Sid110307/LoganLink/hardware/bom.csv

Sl No. | Designator | Description | Qty | MPN | DNP | Footprint | Value
1 | C1,C7 | MLCC 2.2uF 100V X7R 1206 | 2 | CL31B225KCHSNNE |  | Capacitor_SMD:C_1206_3216Metric | 2.2u 100V
2 | C2 | MLCC 100nF 100V X7R 0603 | 1 | GRM188R72A104KA35D |  | Capacitor_SMD:C_0603_1608Metric | 0.1u 100V
3 | C3 | MLCC 1nF 50V C0G 0402 | 1 | GRM1555C1H102JA01D |  | Capacitor_SMD:C_0402_1005Metric | 1n
4 | C4,C9,C13,C15 | MLCC 100nF 50V X7R 0402 | 4 | GCM155R71H104KE02D |  | Capacitor_SMD:C_0402_1005Metric | 0.1u
5 | C5 | MLCC 10nF 50V X7R 0402 | 1 | CL05B103KB5VPNC |  | Capacitor_SMD:C_0402_1005Metric | 10n
6 | C6,C12 | MLCC 1uF 25V X5R 0402 | 2 | GRT155R61E105KE01D |  | Capacitor_SMD:C_0402_1005Metric | 1u
7 | C8 | Aluminium electrolytic 22uF 63V SMD 6.3x7.7 (6.3 mm land pattern) | 1 | UCD1J220MCL1GS |  | Capacitor_SMD:CP_Elec_6.3x5.8 | 22u 63V
8 | C10,C11 | MLCC 22uF 16V X5R 1206 | 2 | GRM31CR61C226KE15L |  | Capacitor_SMD:C_1206_3216Metric | 22u
9 | C14,C16 | MLCC 10uF 10V X5R 0603 | 2 | GRM188R61A106ME69D |  | Capacitor_SMD:C_0603_1608Metric | 10u
10 | D1 | ESD protection diode LIN bus SOD-323 | 1 | PESD1LIN-SL |  | Diode_SMD:D_SOD-323 | PESD1LIN
11 | D2 | TVS diode bidirectional 33V standoff 1500W SMC | 1 | SMCJ33CA-13-F |  | Diode_SMD:D_SMC | SMCJ33CA
12 | D3 | Schottky diode 100V 2A SMA | 1 | SS210-HF |  | Diode_SMD:D_SMA | SS210
13 | D4 | Schottky diode 40V 1A SOD-323 | 1 | B5819WS |  | Diode_SMD:D_SOD-323F | B5819WS
14 | D5,D6 | Dual Schottky diode series 30V SOT-23 | 2 | BAT54S |  | Package_TO_SOT_SMD:SOT-23 | BAT54S
15 | D7 | Switching diode 100V SOT-23 | 1 | BAS16 |  | Package_TO_SOT_SMD:SOT-23 | BAS16
16 | F1 | Fuse fast 2A 63V 1206 | 1 | SF-1206FP200-2 |  | Fuse:Fuse_1206_3216Metric | 2A
17 | F2 | PTC resettable fuse 0.75A hold 6V 1206 | 1 | MF-NSMF075-2 |  | Fuse:Fuse_1206_3216Metric | 0.75A
18 | FB1 | Ferrite bead 600R at 100MHz 1206 | 1 | BLM31PG601SN1L |  | Inductor_SMD:L_1206_3216Metric | BLM31PG601SN1L
19 | J1 | OBD wire pads (not assembled) | 1 | - | DNP | Connector_PinHeader_2.54mm:PinHeader_1x06_P2.54mm_Vertical | OBD
20 | J2 | USB Type-C receptacle USB2.0 16P | 1 | USB4105-GF-A |  | Connector_USB:USB_C_Receptacle_GCT_USB4105-xx-A_16P_TopMnt_Horizontal | USB_C_Receptacle_USB2.0_16P
21 | J3 | UART console pads (not assembled) | 1 | - | DNP | Connector_PinHeader_2.54mm:PinHeader_1x04_P2.54mm_Vertical | UART
22 | L1 | Power inductor 22uH shielded 4x4 Isat 0.95A | 1 | SRN4018-220M |  | Inductor_SMD:L_Bourns-SRN4018 | 22u
23 | LED1 | LED red 0603 | 1 | APT1608EC |  | LED_SMD:LED_0603_1608Metric | Red
24 | LED2 | LED green 0603 | 1 | APT1608SGC |  | LED_SMD:LED_0603_1608Metric | Green
25 | Q1 | N-MOSFET 60V 0.3A SOT-23 | 1 | 2N7002K-7 |  | Package_TO_SOT_SMD:SOT-23 | 2N7002K
26 | R1 | Chip resistor 47R 1% 1/10W 0603 | 1 | RC0603FR-0747RL |  | Resistor_SMD:R_0603_1608Metric | 47
27 | R2,R6,R11,R20 | Chip resistor 100k 1% 1/16W 0402 | 4 | RC0402FR-07100KL |  | Resistor_SMD:R_0402_1005Metric | 100k
28 | R3,R25,R26 | Chip resistor 330R 1% 1/16W 0402 | 3 | RC0402FR-07330RL |  | Resistor_SMD:R_0402_1005Metric | 330
29 | R4,R5 | Chip resistor 5.1k 1% 1/16W 0402 | 2 | RC0402FR-075K1L |  | Resistor_SMD:R_0402_1005Metric | 5.1k
30 | R7,R15,R18 | Chip resistor 1M 0.5% 1/10W 0603 | 3 | RE0603DRE071ML |  | Resistor_SMD:R_0603_1608Metric | 1M
31 | R8,R16 | Chip resistor 150k 0.5% 1/10W 0603 | 2 | RT0603DRE07150KL |  | Resistor_SMD:R_0603_1608Metric | 150k
32 | R9 | Chip resistor 68k 0.5% 1/10W 0603 | 1 | RT0603DRE0768KL |  | Resistor_SMD:R_0603_1608Metric | 68k
33 | R10,R14,R21,R22 | Chip resistor 4.7k 1% 1/16W 0402 | 4 | RC0402FR-074K7L |  | Resistor_SMD:R_0402_1005Metric | 4.7k
34 | R12 | Chip resistor 4.7M 1% 1/16W 0402 | 1 | RC0402FR-074M7L |  | Resistor_SMD:R_0402_1005Metric | 4.7M
35 | R13,R23,R24 | Chip resistor 10k 1% 1/16W 0402 | 3 | RC0402FR-0710KL |  | Resistor_SMD:R_0402_1005Metric | 10k
36 | R17 | Chip resistor 510R 1% 0.5W 1206 anti-surge | 1 | CRCW1206510RFKEAHP |  | Resistor_SMD:R_1206_3216Metric | 510 0.5W
37 | R19 | Chip resistor 43.2k 1% 1/16W 0402 | 1 | RC0402FR-0743K2L |  | Resistor_SMD:R_0402_1005Metric | 43.2k
38 | SW1 | Tactile switch SPST-NO SMD (reset; not assembled) | 1 | B3U-1100P-B | DNP | Button_Switch_SMD:SW_SPST_B3U-1000P | SW_RESET
39 | SW2 | Tactile switch SPST-NO SMD 2-pin | 1 | B3U-1100P-B |  | Button_Switch_SMD:SW_SPST_B3U-1000P | SW_PAIR
40 | TP1,TP2,TP3,TP4 | Test pad (not assembled) | 4 | - | DNP | TestPoint:TestPoint_Pad_D1.0mm | TestPoint_Small
41 | U1 | USB ESD protection diode array SOT-23-6 | 1 | USBLC6-2SC6 |  | Package_TO_SOT_SMD:SOT-23-6 | USBLC6-2SC6
42 | U2 | Comparator low-voltage open-drain SOT-23-5 | 1 | LMV331IDBVR |  | Package_TO_SOT_SMD:SOT-23-5 | LMV331
43 | U3 | Buck converter 60V 0.6A 3.3V VQFN-HR-12 | 1 | LMR36006AQRNXRQ1 |  | loganlink:TI_RNX0012A | LMR36006AQRNXRQ1
44 | U4 | CAN transceiver 3.3V SOIC-8 (CAN cars only) | 1 | SN65HVD230QDRQ1 | DNP | Package_SO:SOIC-8_3.9x4.9mm_P1.27mm | SN65HVD230
45 | U5 | Accelerometer 3-axis I2C LGA-12 | 1 | LIS2DW12TR |  | Package_LGA:LGA-12_2x2mm_P0.5mm | LIS2DW12TR
46 | U6 | Wi-Fi + BLE module ESP32-S3 8MB flash | 1 | ESP32-S3-MINI-1-N8 |  | RF_Module:ESP32-S2-MINI-1 | ESP32-S3-MINI-1-N8
