Sid110307/LoganLink/mechanical/LoganLink-dongle.FCStd

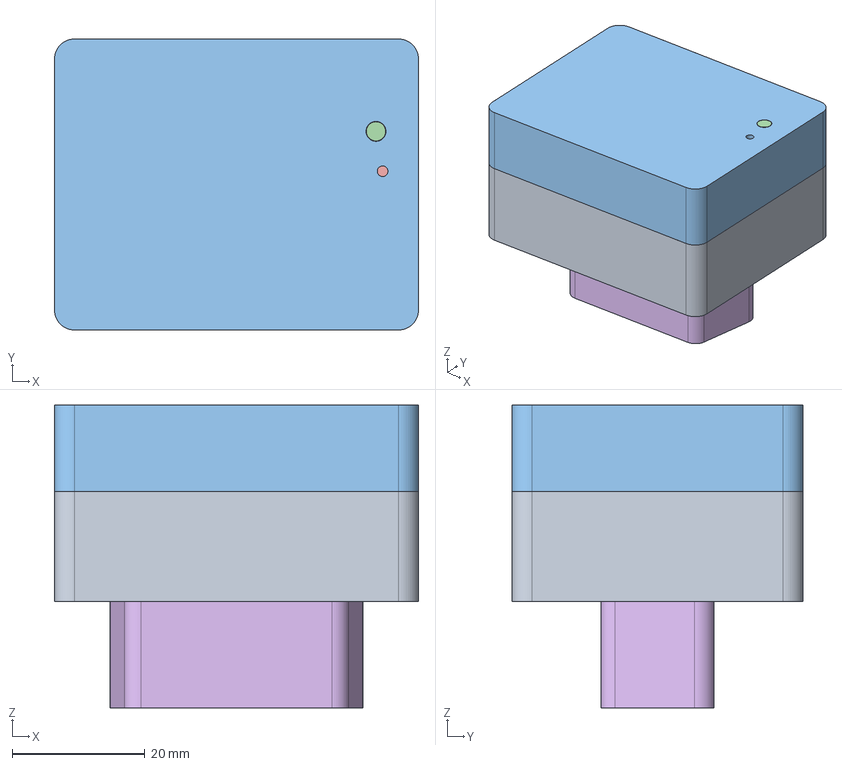
[picture p1: CAD file, 2026-11-09]
mechanical/LoganLink-dongle.FCStd
54.8 x 43.8 x 45.6 mm
Front
Retainer
Rear
LightPipe
PCB_ref
OBDPlug_ref
