Sid110307/LoganLink/mechanical/dongle-pipe.stl

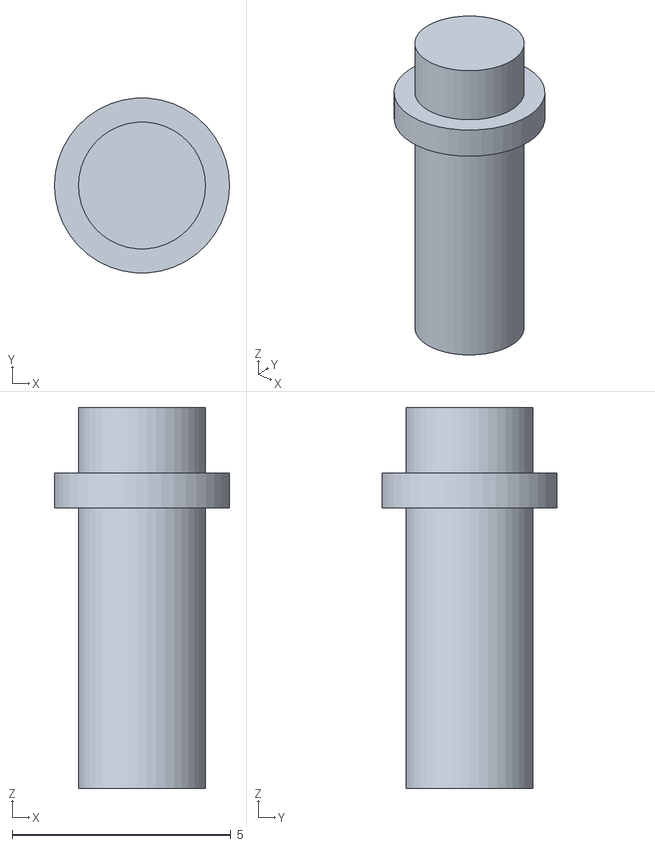
[picture p2: CAD file, 2026-11-09]
mechanical/dongle-pipe.stl
4.00 x 3.99 x 8.70
