Sid110307/LoganLink/mechanical/dongle-rear.stl

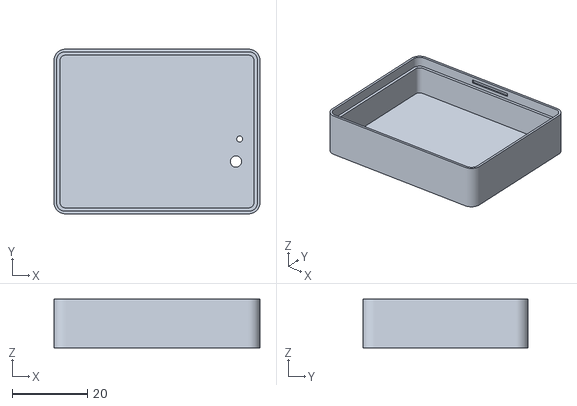
[picture p3: CAD file, 2026-11-09]
mechanical/dongle-rear.stl
54.8 x 43.8 x 13.0
