Sid110307/LoganLink/mechanical/dongle.step

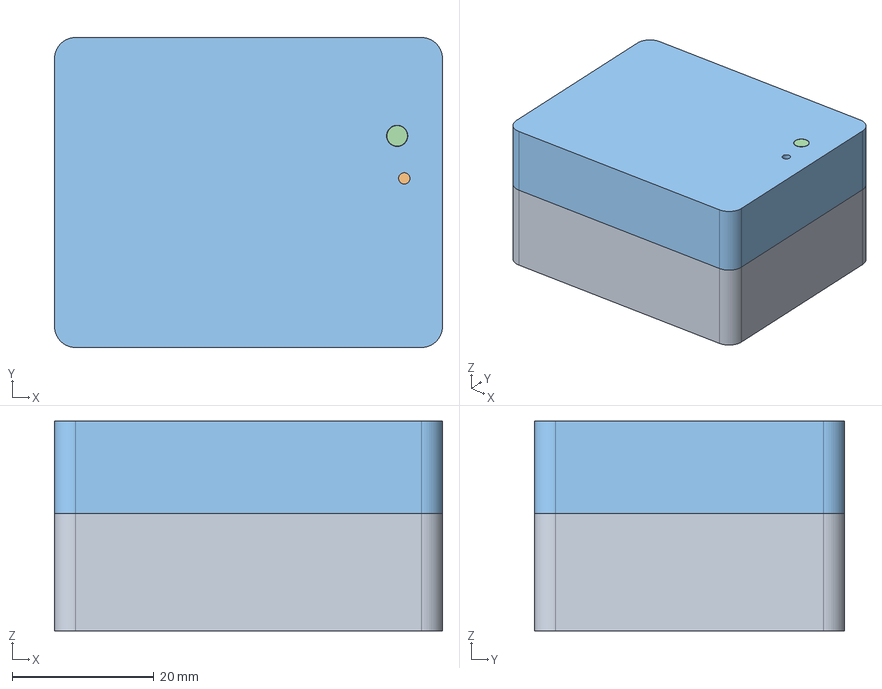
[picture p4: CAD file, 2026-11-09]
mechanical/dongle.step
54.8 x 43.8 x 29.6 mm
Front
Retainer
Rear
LightPipe
