Sid110307/LoganLink/mechanical/dongle-front.stl

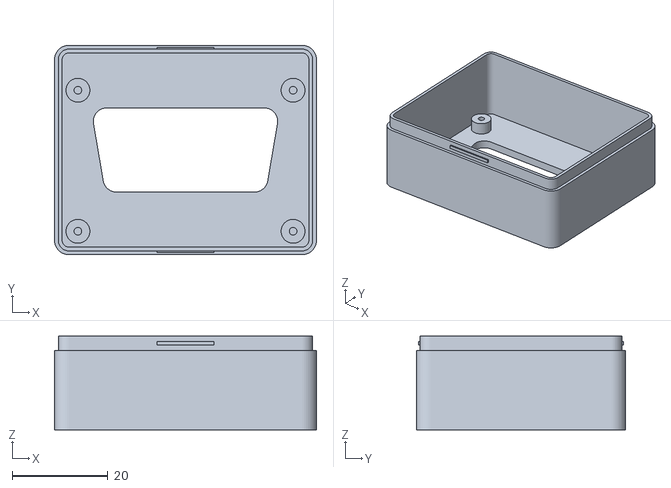
[picture p5: CAD file, 2026-11-09]
mechanical/dongle-front.stl
54.8 x 43.8 x 19.6
