Sid110307/LoganLink/mechanical/dongle-retainer.stl

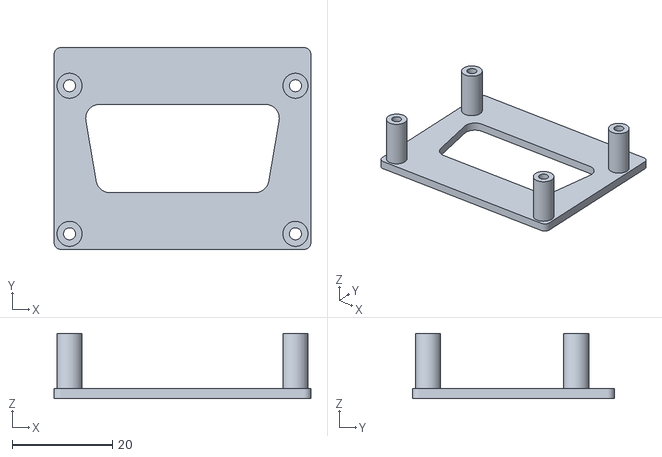
[picture p6: CAD file, 2026-11-09]
mechanical/dongle-retainer.stl
51.2 x 40.2 x 13.0
