Sid110307/LoganLink/hardware/pcb/pcb.kicad_pcb

## KiCad design hardware/pcb/pcb.kicad_pcb (2026-11-09)

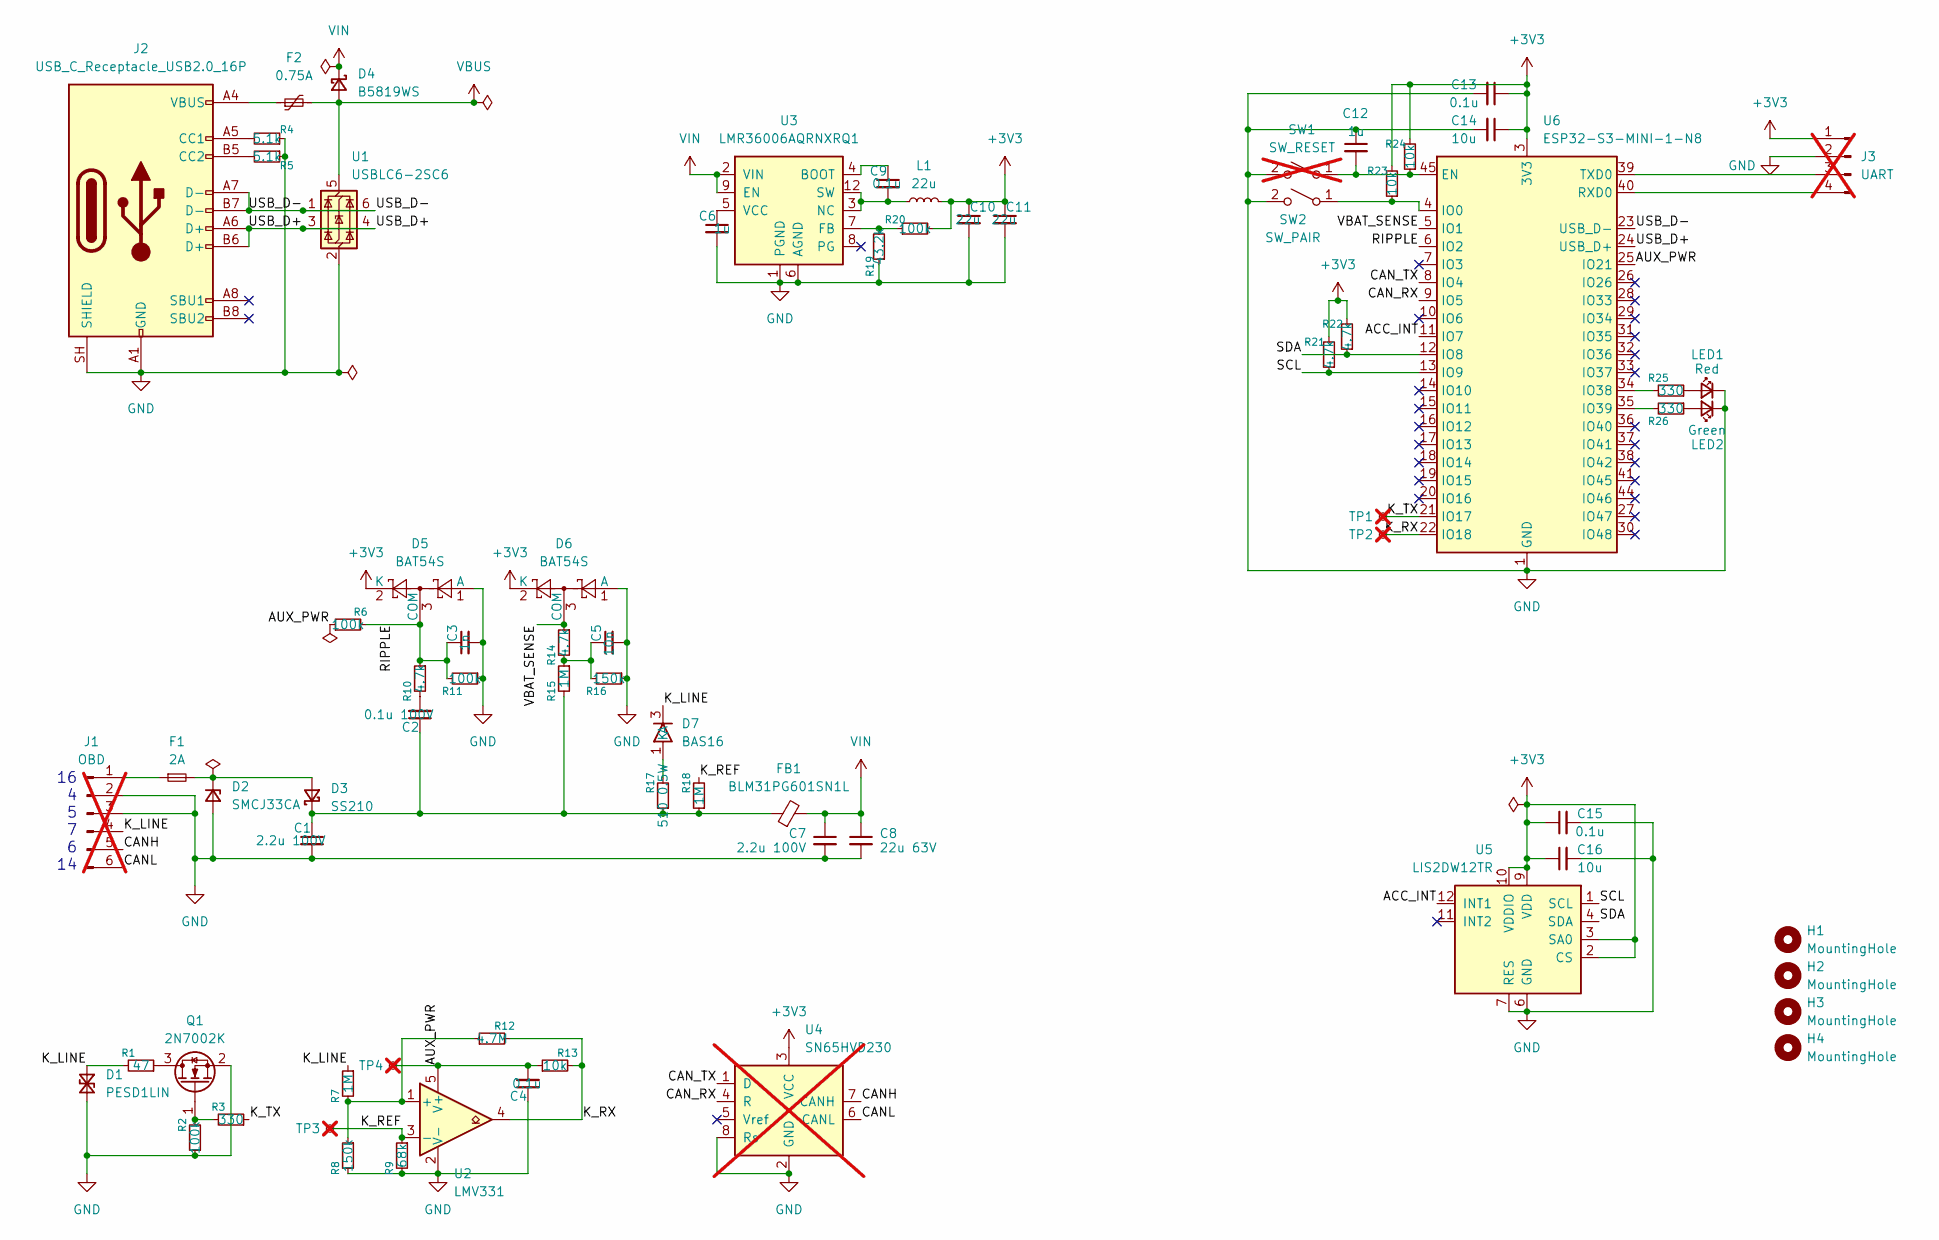
[picture p7: schematic pcb.kicad_sch]

Parts:
C1, C7: 2.2u 100V; C_1206_3216Metric; MPN CL31B225KCHSNNE
C2: 0.1u 100V; C_0603_1608Metric; MPN GRM188R72A104KA35D
C3: 1n; C_0402_1005Metric; MPN GRM1555C1H102JA01D
C4, C9, C13, C15: 0.1u; C_0402_1005Metric; MPN GCM155R71H104KE02D
C5: 10n; C_0402_1005Metric; MPN CL05B103KB5VPNC
C6, C12: 1u; C_0402_1005Metric; MPN GRT155R61E105KE01D
C8: 22u 63V; CP_Elec_6.3x5.8; MPN UCD1J220MCL1GS
C10, C11: 22u; C_1206_3216Metric; MPN GRM31CR61C226KE15L
C14, C16: 10u; C_0603_1608Metric; MPN GRM188R61A106ME69D
D1: PESD1LIN; D_SOD-323; MPN PESD1LIN-SL
D2: SMCJ33CA; D_SMC; MPN SMCJ33CA-13-F
D3: SS210; D_SMA; MPN SS210-HF
D4: B5819WS; D_SOD-323F; MPN B5819WS
D5, D6: BAT54S; SOT-23; MPN BAT54S
D7: BAS16; SOT-23; MPN BAS16
F1: 2A; Fuse_1206_3216Metric; MPN SF-1206FP200-2
F2: 0.75A; Fuse_1206_3216Metric; MPN MF-NSMF075-2
FB1: BLM31PG601SN1L; L_1206_3216Metric; MPN BLM31PG601SN1L
H1, H2, H3, H4: MountingHole; MountingHole_2.2mm_M2
J1: OBD; PinHeader_1x06_P2.54mm_Vertical; not fitted
J2: USB_C_Receptacle_USB2.0_16P; USB_C_Receptacle_GCT_USB4105-xx-A_16P_TopMnt_Horizontal; MPN USB4105-GF-A
J3: UART; PinHeader_1x04_P2.54mm_Vertical; not fitted
L1: 22u; L_Bourns-SRN4018; MPN SRN4018-220M
LED1: Red; LED_0603_1608Metric; MPN APT1608EC
LED2: Green; LED_0603_1608Metric; MPN APT1608SGC
Q1: 2N7002K; SOT-23; MPN 2N7002K-7
R1: 47; R_0603_1608Metric; MPN RC0603FR-0747RL
R2, R6, R11, R20: 100k; R_0402_1005Metric; MPN RC0402FR-07100KL
R3, R25, R26: 330; R_0402_1005Metric; MPN RC0402FR-07330RL
R4, R5: 5.1k; R_0402_1005Metric; MPN RC0402FR-075K1L
R7, R15, R18: 1M; R_0603_1608Metric; MPN RE0603DRE071ML
R8, R16: 150k; R_0603_1608Metric; MPN RT0603DRE07150KL
R9: 68k; R_0603_1608Metric; MPN RT0603DRE0768KL
R10, R14, R21, R22: 4.7k; R_0402_1005Metric; MPN RC0402FR-074K7L
R12: 4.7M; R_0402_1005Metric; MPN RC0402FR-074M7L
R13, R23, R24: 10k; R_0402_1005Metric; MPN RC0402FR-0710KL
R17: 510 0.5W; R_1206_3216Metric; MPN CRCW1206510RFKEAHP
R19: 43.2k; R_0402_1005Metric; MPN RC0402FR-0743K2L
SW1: SW_RESET; SW_SPST_B3U-1000P; MPN B3U-1100P-B; not fitted
SW2: SW_PAIR; SW_SPST_B3U-1000P; MPN B3U-1100P-B
TP1, TP2, TP3, TP4: TestPoint_Small; TestPoint_Pad_D1.0mm; not fitted
U1: USBLC6-2SC6; SOT-23-6; MPN USBLC6-2SC6
U2: LMV331; SOT-23-5; MPN LMV331IDBVR
U3: LMR36006AQRNXRQ1; TI_RNX0012A; MPN LMR36006AQRNXRQ1
U4: SN65HVD230; SOIC-8_3.9x4.9mm_P1.27mm; MPN SN65HVD230QDRQ1; not fitted
U5: LIS2DW12TR; LGA-12_2x2mm_P0.5mm; MPN LIS2DW12TR
U6: ESP32-S3-MINI-1-N8; ESP32-S2-MINI-1; MPN ESP32-S3-MINI-1-N8

Connections:
+3V3: C10.1, C11.1, C13.1, C14.1, C15.1, C16.1, D5.2 (K), D6.2 (K), J3.1, L1.2, R20.2, R21.2, R22.2, R23.2, R24.2, U4.3 (VCC), U5.2 (CS), U5.3 (SA0), U5.9 (VDD), U5.10 (VDDIO), U6.3 (3V3)
/ACC_INT: U5.12 (INT1), U6.11 (IO7)
/AUX_PWR: C4.2, R6.1, R13.1, TP4.1 (1_1), U2.5 (V+), U6.25 (IO21)
/CANH: J1.5, U4.7 (CANH)
/CANL: J1.6, U4.6 (CANL)
/CAN_RX: U4.4 (R), U6.9 (IO5)
/CAN_TX: U4.1 (D), U6.8 (IO4)
/K_LINE: D1.1 (A1), D7.3 (K), J1.4, R1.2, R7.1
/K_REF: R9.1, R18.2, TP3.1 (1_1), U2.3 (-)
/K_RX: R12.2, R13.2, TP2.1 (1_1), U2.4, U6.22 (IO18)
/K_TX: R3.1, TP1.1 (1_1), U6.21 (IO17)
/RIPPLE: C3.1, D5.3 (COM), R6.2, R10.1, R11.2, U6.6 (IO2)
/SCL: R21.1, U5.1 (SCL), U6.13 (IO9)
/SDA: R22.1, U5.4 (SDA), U6.12 (IO8)
/USB_D+: J2.A6 (D+), J2.B6 (D+), U1.3 (I/O2), U1.4 (I/O2), U6.24 (USB_D+)
/USB_D-: J2.A7 (D-), J2.B7 (D-), U1.1 (I/O1), U1.6 (I/O1), U6.23 (USB_D-)
/VBAT_SENSE: D6.3 (COM), R14.1, U6.5 (IO1)
GND: C1.2, C3.2, C4.1, C5.2, C6.2, C7.2, C8.2, C10.2, C11.2, C12.1, C13.2, C14.2, C15.2, C16.2, D1.2 (A2), D2.2 (A), D5.1 (A), D6.1 (A), J1.2, J1.3, J2.A1 (GND), J2.A12 (GND), J2.B1 (GND), J2.B12 (GND), J2.SH (SHIELD), J3.2, LED1.1 (K), LED2.1 (K), Q1.2 (S), R2.1, R4.1, R5.1, R8.2, R9.2, R11.1, R16.1, R19.1, SW1.2 (B), SW2.2 (B), U1.2 (GND), U2.2 (V-), U3.1 (PGND), U3.6 (AGND), U3.11 (PGND), U4.2 (GND), U4.8 (Rs), U5.6 (GND), U5.7 (RES), U5.8 (GND), U6.1 (GND), U6.2 (GND), U6.42 (GND), U6.43 (GND), U6.46 (GND), U6.47 (GND), U6.48 (GND), U6.49 (GND), U6.50 (GND), U6.51 (GND), U6.52 (GND), U6.53 (GND), U6.54 (GND), U6.55 (GND), U6.56 (GND), U6.57 (GND), U6.58 (GND), U6.59 (GND), U6.60 (GND), U6.61 (GND), U6.62 (GND), U6.63 (GND), U6.64 (GND), U6.65 (GND)
unnamed: C2.2, R10.2
unnamed: C5.1, R14.2, R15.1, R16.2
unnamed: D2.1 (K), D3.2 (A), F1.2
unnamed: C1.1, C2.1, D3.1 (K), FB1.1, R15.2, R17.1, R18.1
unnamed: D7.1 (A), R17.2
unnamed: F2.1, J2.A4 (VBUS), J2.A9 (VBUS), J2.B4 (VBUS), J2.B9 (VBUS)
unnamed: F1.1, J1.1
unnamed: J2.A5 (CC1), R4.2
unnamed: J2.B5 (CC2), R5.2
unnamed: J3.3, U6.39 (TXD0)
unnamed: J3.4, U6.40 (RXD0)
unnamed: LED1.2 (A), R25.1
unnamed: LED2.2 (A), R26.1
unnamed: Q1.3 (D), R1.1
unnamed: Q1.1 (G), R2.2, R3.2
unnamed: C12.2, R24.1, SW1.1 (A), U6.45 (EN)
unnamed: R23.1, SW2.1 (A), U6.4 (IO0)
unnamed: R7.2, R8.1, R12.1, U2.1 (+)
unnamed: C9.1, U3.4 (BOOT)
unnamed: R19.2, R20.1, U3.7 (FB)
unnamed: C9.2, L1.1, U3.3 (NC), U3.12 (SW)
unnamed: C6.1, U3.5 (VCC)
unnamed: R25.2, U6.34 (IO38)
unnamed: R26.2, U6.35 (IO39)
VBUS: D4.2 (A), F2.2, U1.5 (VBUS)
VIN: C7.1, C8.1, D4.1 (K), FB1.2, U3.2 (VIN), U3.9 (EN), U3.10 (VIN)

Notes on the sheet:
16 4 5 7 6 14

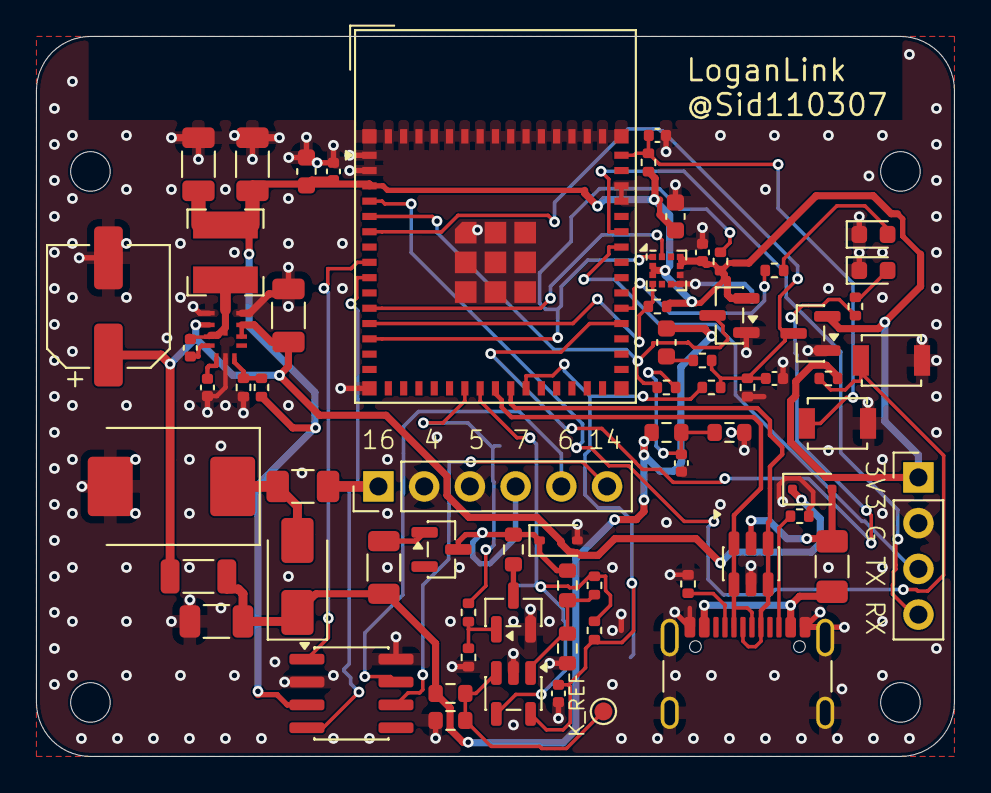
[picture p8: board pcb.kicad_pcb from above]

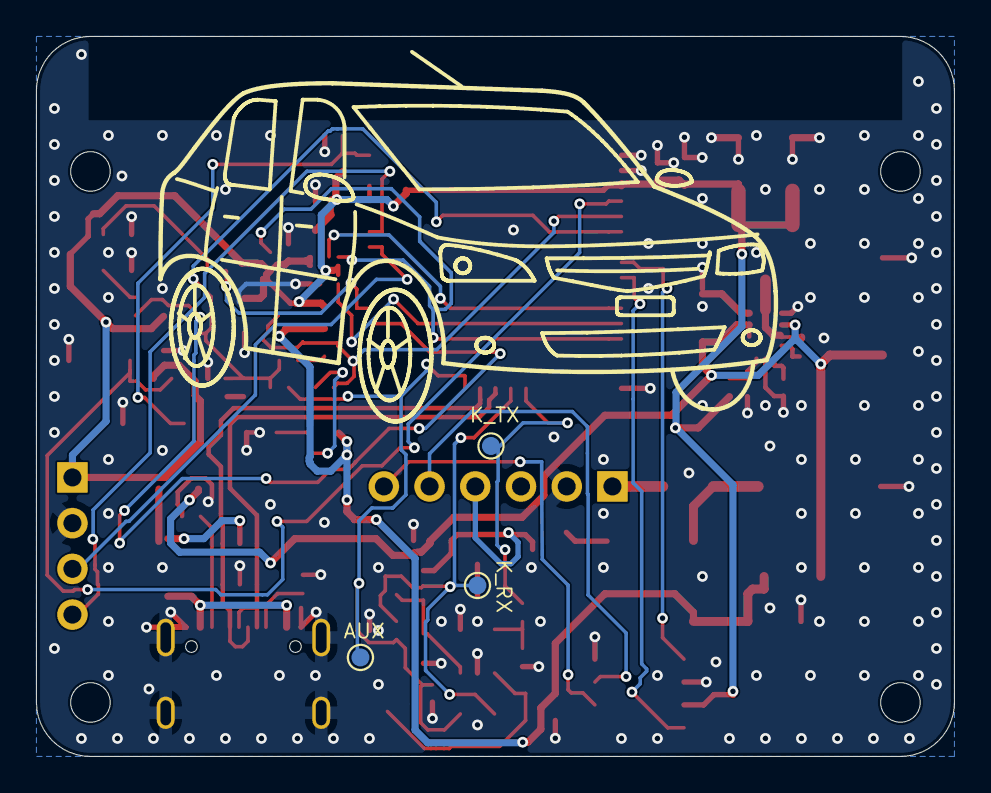
[picture p9: board pcb.kicad_pcb from below]

Board: 2 copper layers, 51.0 x 40.0 mm, 75 parts (3 on the bottom side), 44 nets.
