Sid110307/LoganLink/(commit log)

2026-10-29 Hardware + enclosure stuff
    [bom-revA.csv, bom-revB.csv, dongle.scad, enclosure.scad, pinmap-revA.csv, pinmap-revB.csv]
2026-11-03 firmware. k-line driver, ble, logger, power states. haven't compiled it yet
    [partitions.csv]
2026-11-08 ( ͡° ͜ʖ ͡°)
2026-11-08 make it generic, not just for one car
    [bom-revB.csv, pinmap-revB.csv]
2026-11-08 Plate formatting + RTO lookup, read VIN from the ECU during probe
2026-11-08 cad shit
    [LoganLink-dongle.FCStd, bom-revA.csv, bom-revB.csv, dongle-bottom.stl, dongle-pipe.stl, dongle-top.stl, dongle.scad, dongle.step]
2026-11-08 Rewrote the docs, way shorter now
    [bom-revA.csv, bom-revB.csv, pinmap-revA.csv, pinmap-revB.csv]
2026-11-08 single bom + pinmap, cheaper button/inductor, no 32k crystal
    [bom.csv, pinmap.csv]
2026-11-08 Enclosure sits straight out of the socket now, 3 printed parts + retainer clamps the plug
    [LoganLink-dongle.FCStd, dongle-bottom.stl, dongle-front.stl, dongle-pipe.stl, dongle-rear.stl, dongle-retainer.stl, dongle-top.stl, dongle.step]
2026-11-08 hardware, kicad, enclosure, bom docs
    [bom.csv]
2026-11-08 kicad project lib with the buck symbol
2026-11-08 buck footprint from TI
2026-11-08 courtyard on the buck footprint
2026-11-08 docs match the current hardware + firmware now
2026-11-08 accel + bas16 symbols, fixed two footprint names
    [bom.csv]
2026-11-08 hasl instead of enig
    [bom.csv]
2026-11-08 Schematic done, board outline + main parts placed, design rules
    [pcb.kicad_pcb, pcb.kicad_sch]
2026-11-08 PCB placement done, board shrunk to 51x40 with gnd pours
    [bom.csv, pcb.kicad_pcb, pcb.kicad_sch]
2026-11-09 PCB route donee
    [pcb.kicad_pcb]
2026-11-09 car outline for the silkscreen
2026-11-09 test points, cleaned up the leftover routing junk
    [pcb.kicad_pcb, pcb.kicad_sch]
2026-11-09 usb pair redone properly, rerouted signals around it
    [pcb.kicad_pcb]
2026-11-09 enclosure updated for the new board, holes and light pipe moved
    [LoganLink-dongle.FCStd, dongle-front.stl, dongle-pipe.stl, dongle-rear.stl, dongle-retainer.stl, dongle.step]
2026-11-09 bom/docs: both buttons are B3U, fixed hole and led positions
    [bom.csv]
2026-11-09 Removed shit
    [LoganLink-dongle.FCStd, bom.csv, dongle-pipe.stl, dongle-rear.stl, dongle.step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]
